indrekluuk/RobotexLineFollowerMain/pcb/MainBoard/Drill.png

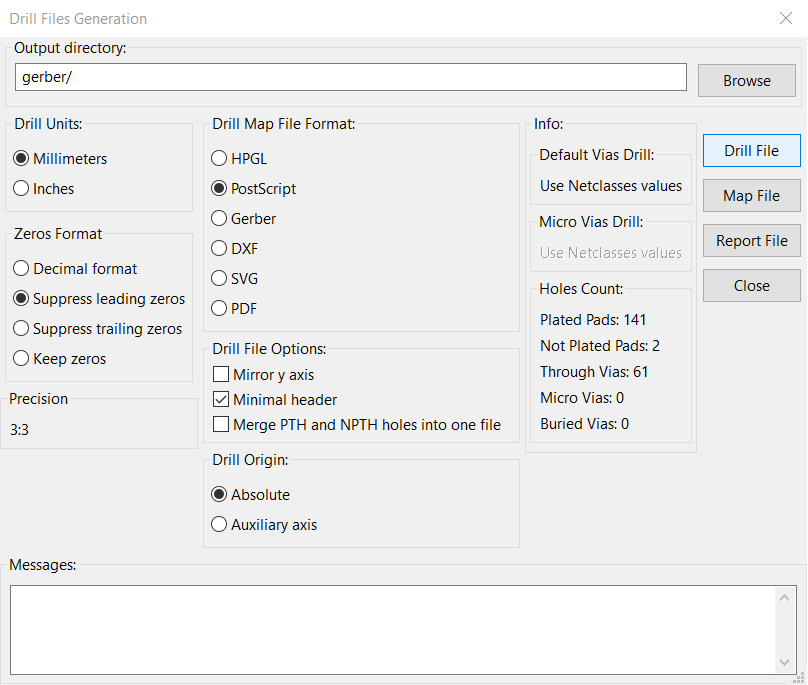
pcb/MainBoard/Drill.png
