indrekluuk/RobotexLineFollowerMain/pcb/MainBoard/MainBoard.kicad_pcb

## KiCad design pcb/MainBoard/MainBoard.kicad_pcb (2016-11-05)

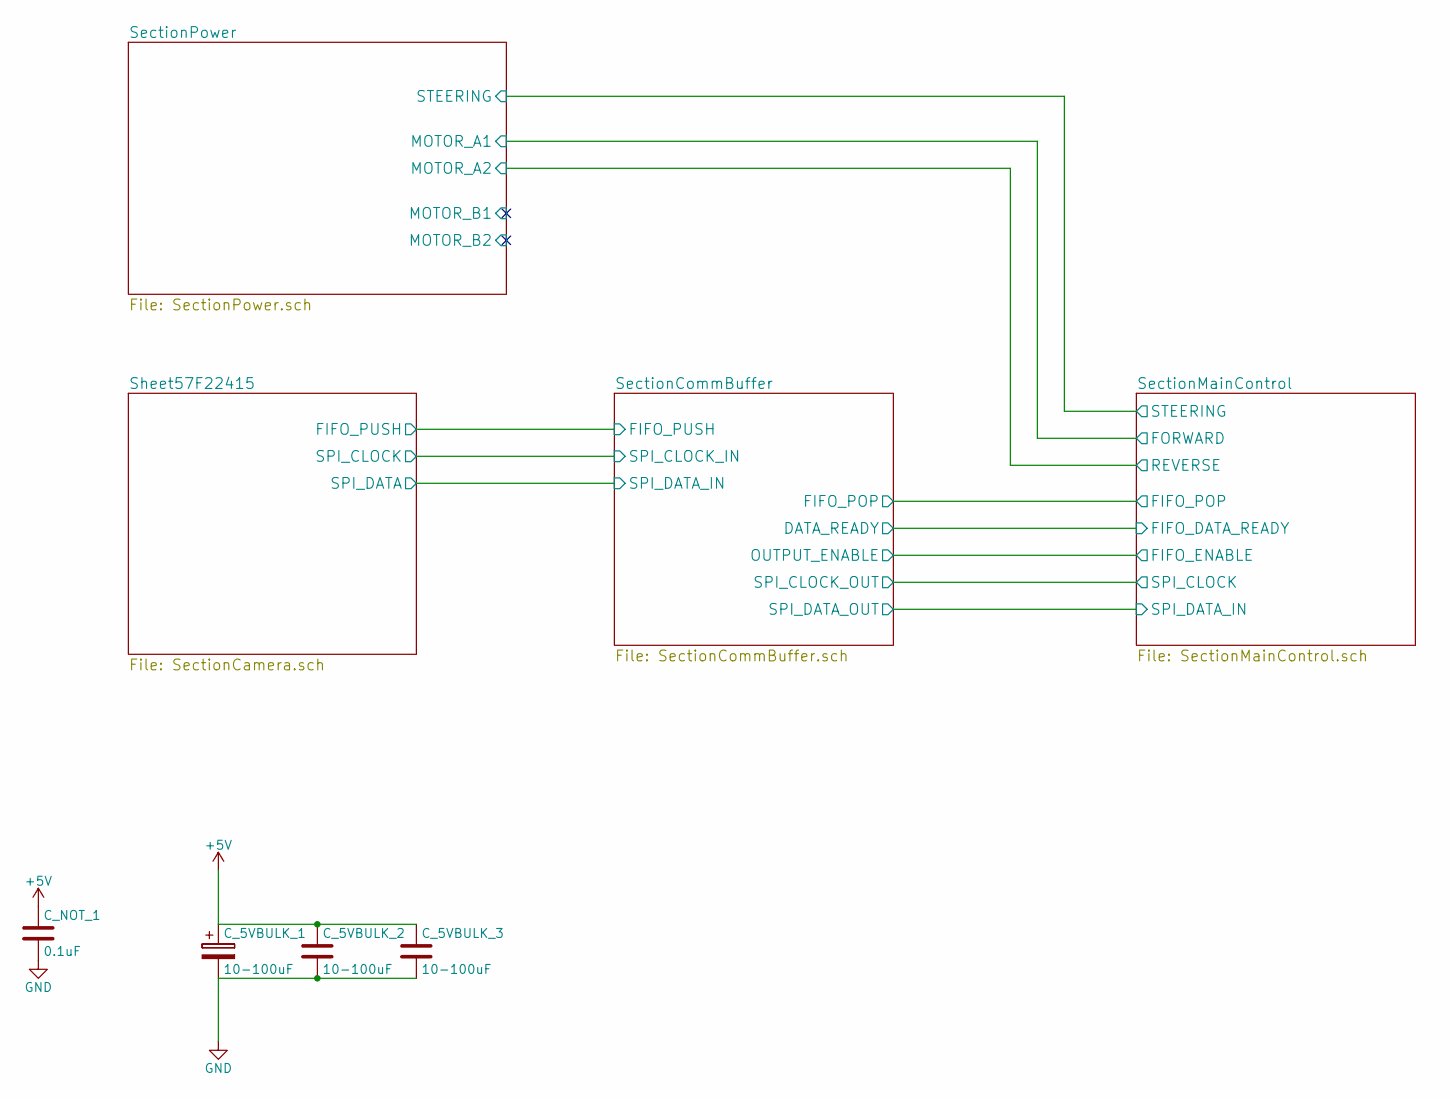
[picture p3: schematic MainBoard.sch]

Parts:
C_5VBULK_1: 10-100uF; C_Radial_D6.3_L11.2_P2.5
C_5VBULK_2, C_5VBULK_3: 10-100uF; C_1206_HandSoldering
C_NOT_1: 0.1uF; C_1206_HandSoldering

Connections:
+5V: C_5VBULK_1.1, C_5VBULK_2.1, C_5VBULK_3.1, C_NOT_1.1; also elsewhere on the board
GND: C_5VBULK_1.2, C_5VBULK_2.2, C_5VBULK_3.2, C_NOT_1.2; also elsewhere on the board

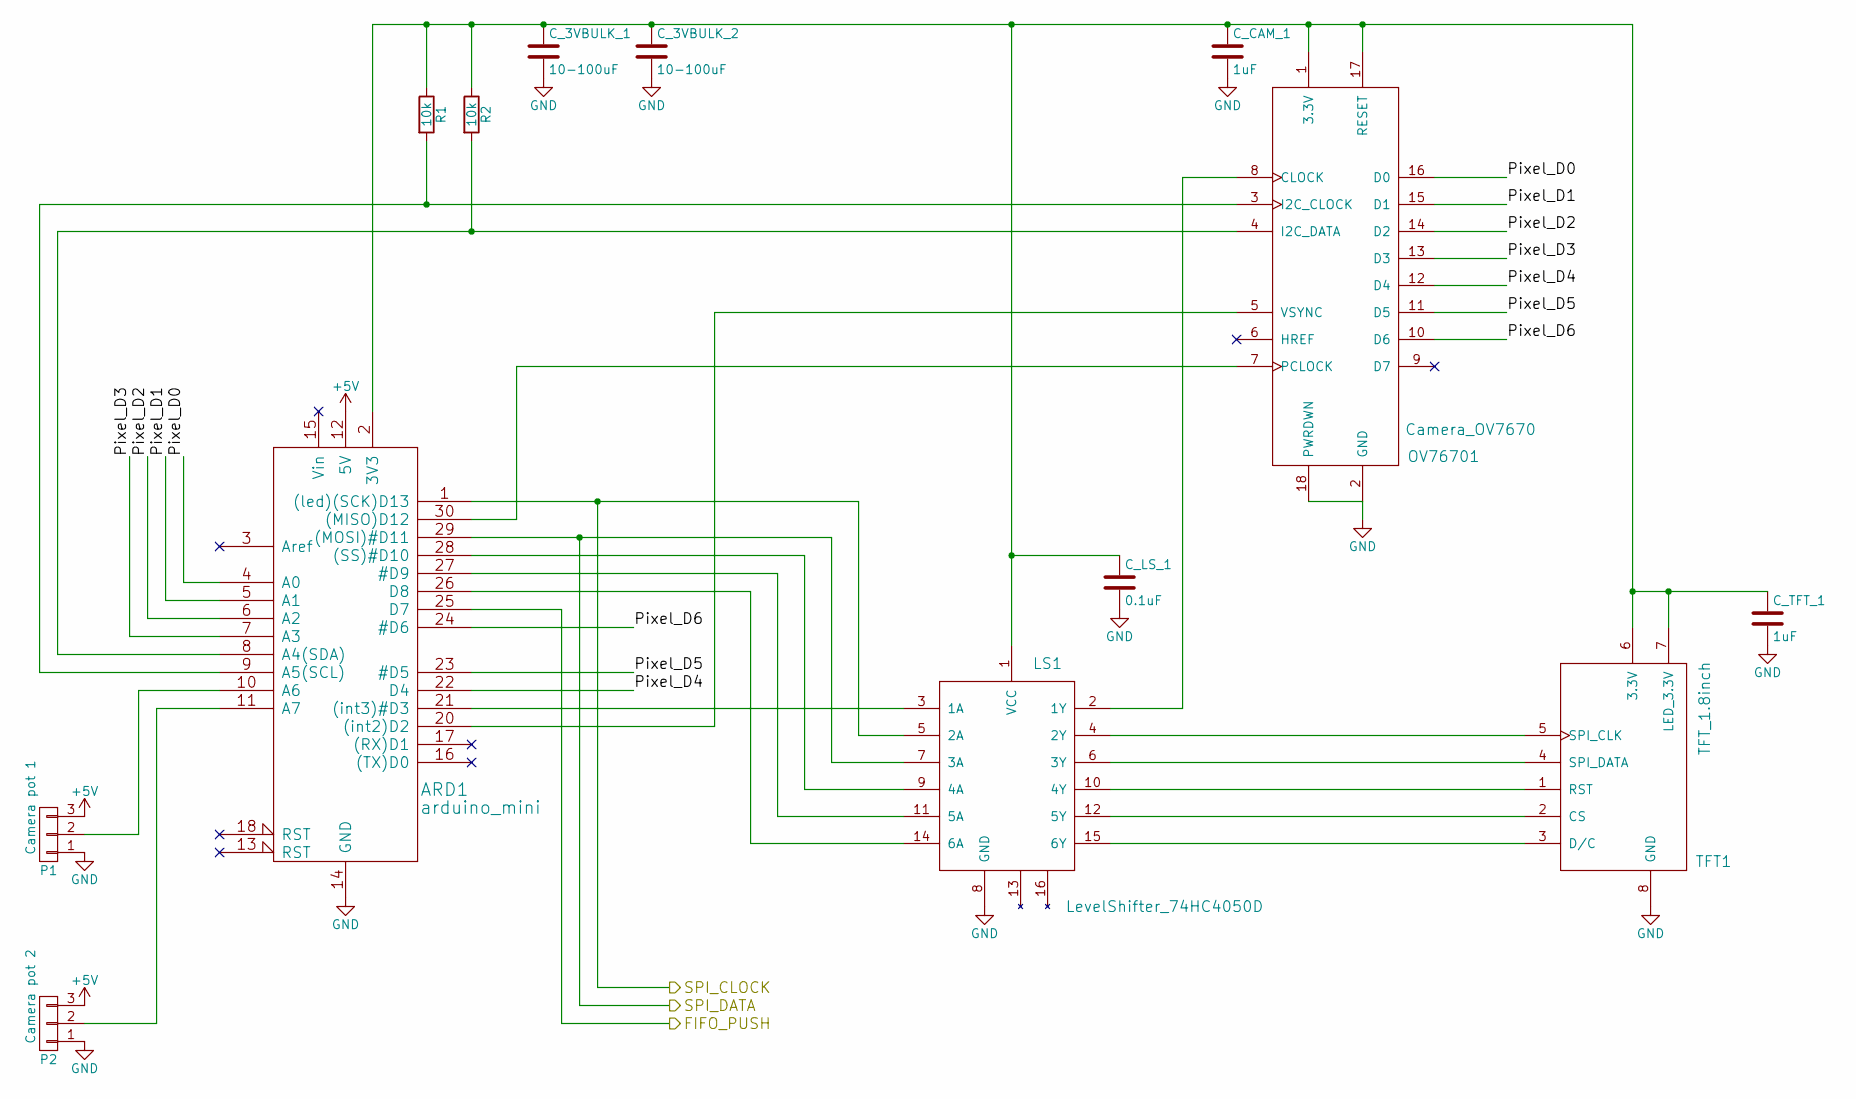
[picture p4: schematic SectionCamera.sch]

Parts:
ARD1: arduino_mini
C_3VBULK_1, C_3VBULK_2: 10-100uF; C_1206_HandSoldering
C_CAM_1: 1uF; C_1206_HandSoldering
C_LS_1: 0.1uF; C_1206_HandSoldering
C_TFT_1: 1uF; C_1206_HandSoldering
LS1: LevelShifter_74HC4050D; SOIC-16_3.9x9.9mm_Pitch1.27mm
OV76701: Camera_OV7670; Pin_Header_Straight_2x09
P1: Camera pot 1; Pin_Header_Straight_1x03
P2: Camera pot 2; Pin_Header_Straight_1x03
R1, R2: 10k; R_1206_HandSoldering
TFT1: TFT_1.8inch; Pin_Header_Straight_2x04

Connections:
+5V: ARD1.12 (5V), P1.3, P2.3; also elsewhere on the board
/SectionCommBuffer/FIFO_PUSH: ARD1.25 (D7); also elsewhere on the board
/Sheet57F22415/Pixel_D0: ARD1.4 (A0), OV76701.16 (D0)
/Sheet57F22415/Pixel_D1: ARD1.5 (A1), OV76701.15 (D1)
/Sheet57F22415/Pixel_D2: ARD1.6 (A2), OV76701.14 (D2)
/Sheet57F22415/Pixel_D3: ARD1.7 (A3), OV76701.13 (D3)
/Sheet57F22415/Pixel_D4: ARD1.22 (D4), OV76701.12 (D4)
/Sheet57F22415/Pixel_D5: ARD1.23 (#D5), OV76701.11 (D5)
/Sheet57F22415/Pixel_D6: ARD1.24 (#D6), OV76701.10 (D6)
/Sheet57F22415/SPI_CLOCK: ARD1.1 ((led)(SCK)D13), LS1.5 (2A); also elsewhere on the board
/Sheet57F22415/SPI_DATA: ARD1.29 ((MOSI)#D11), LS1.7 (3A); also elsewhere on the board
GND: ARD1.14 (GND), ARD1.19 (GND), C_3VBULK_1.2, C_3VBULK_2.2, C_CAM_1.2, C_LS_1.2, C_TFT_1.2, LS1.8 (GND), OV76701.2 (GND), OV76701.18 (PWRDWN), P1.1, P2.1, TFT1.8 (GND); also elsewhere on the board
unnamed: ARD1.2 (3V3), C_3VBULK_1.1, C_3VBULK_2.1, C_CAM_1.1, C_LS_1.1, C_TFT_1.1, LS1.1 (VCC), OV76701.1 (3.3V), OV76701.17 (RESET), R1.1, R2.1, TFT1.6 (3.3V), TFT1.7 (LED_3.3V)
unnamed: ARD1.8 (A4(SDA)), OV76701.4 (I2C_DATA), R2.2
unnamed: ARD1.9 (A5(SCL)), OV76701.3 (I2C_CLOCK), R1.2
unnamed: ARD1.10 (A6), P1.2
unnamed: ARD1.11 (A7), P2.2
unnamed: ARD1.20 ((int2)D2), OV76701.5 (VSYNC)
unnamed: ARD1.21 ((int3)#D3), LS1.3 (1A)
unnamed: ARD1.26 (D8), LS1.14 (6A)
unnamed: ARD1.27 (#D9), LS1.11 (5A)
unnamed: ARD1.28 ((SS)#D10), LS1.9 (4A)
unnamed: ARD1.30 ((MISO)D12), OV76701.7 (PCLOCK)
unnamed: LS1.2 (1Y), OV76701.8 (CLOCK)
unnamed: LS1.4 (2Y), TFT1.5 (SPI_CLK)
unnamed: LS1.6 (3Y), TFT1.4 (SPI_DATA)
unnamed: LS1.10 (4Y), TFT1.1 (RST)
unnamed: LS1.12 (5Y), TFT1.2 (CS)
unnamed: LS1.15 (6Y), TFT1.3 (D/C)

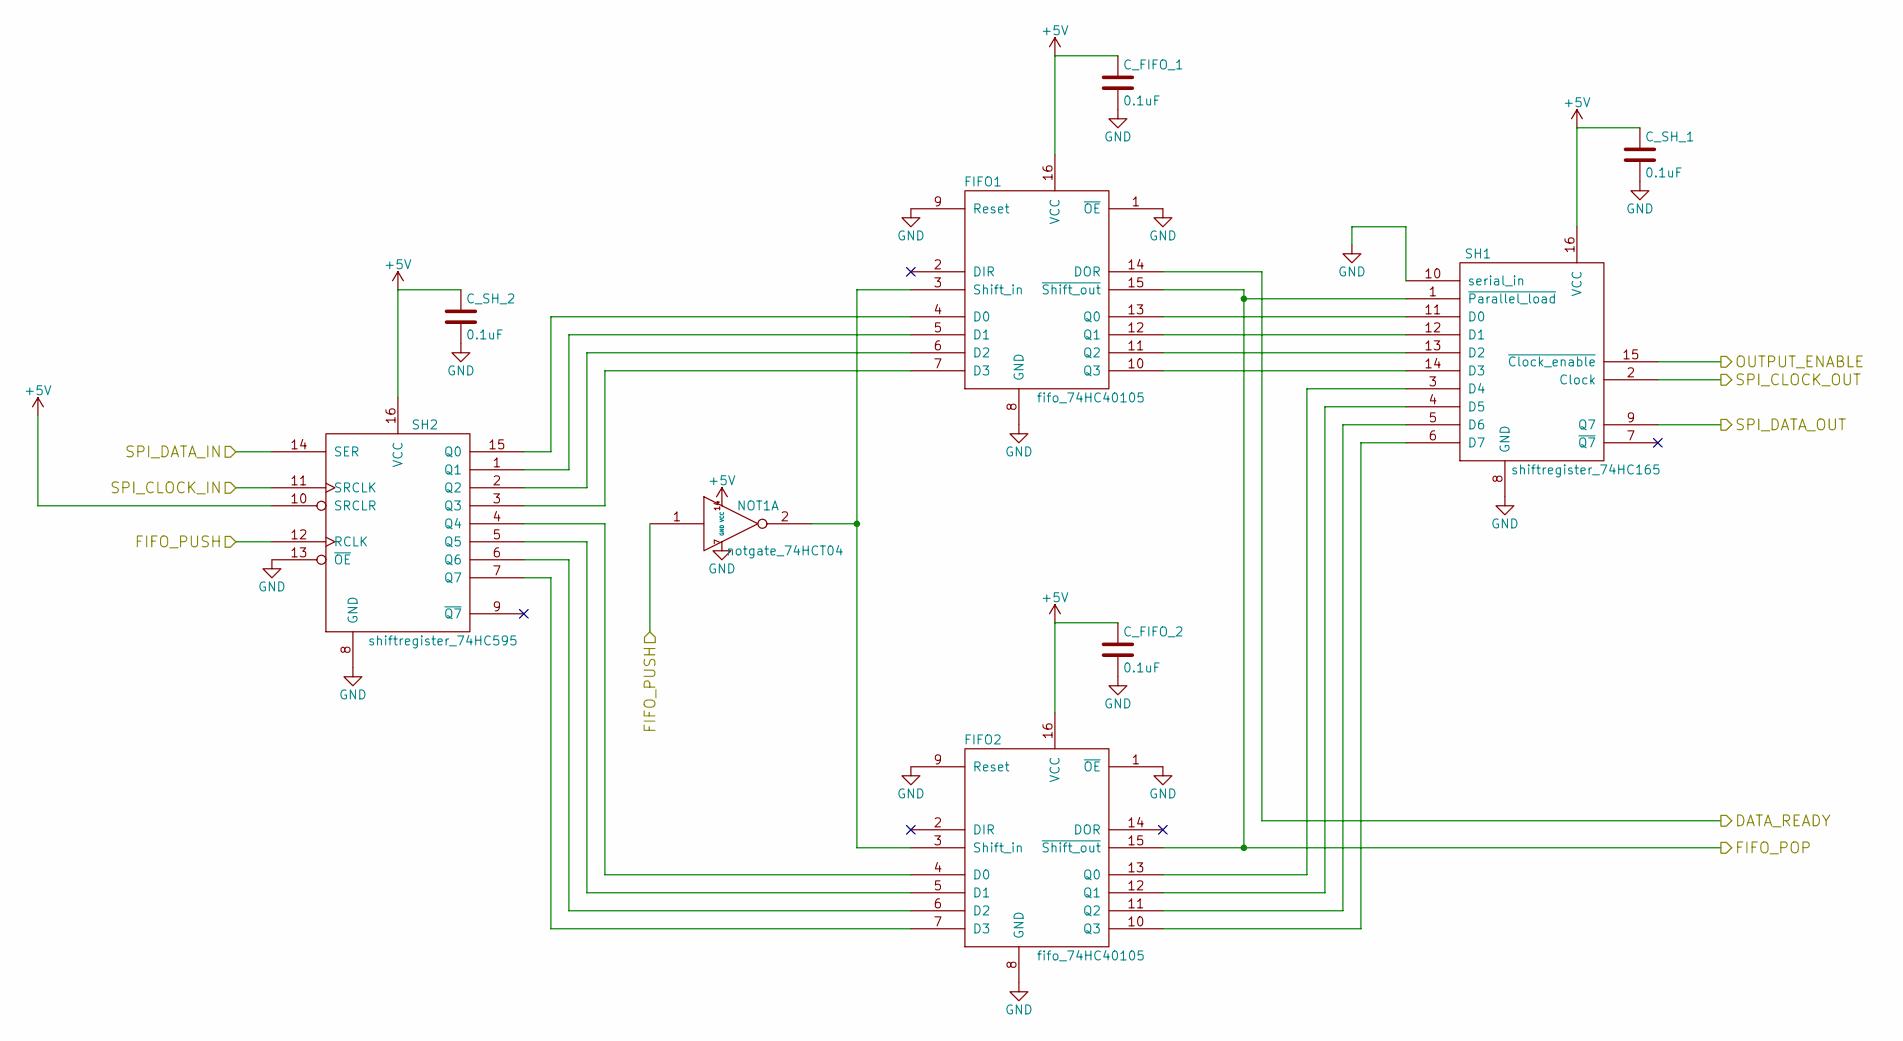
[picture p5: schematic SectionCommBuffer.sch]

Parts:
C_FIFO_1, C_FIFO_2: 0.1uF; C_1206_HandSoldering
C_SH_1, C_SH_2: 0.1uF; C_1206_HandSoldering
FIFO1, FIFO2: fifo_74HC40105; SOIC-16_3.9x9.9mm_Pitch1.27mm
NOT1: notgate_74HCT04; SOIC-14_3.9x8.7mm_Pitch1.27mm
SH1: shiftregister_74HC165; SOIC-16_3.9x9.9mm_Pitch1.27mm
SH2: shiftregister_74HC595; SOIC-16_3.9x9.9mm_Pitch1.27mm

Connections:
+5V: C_FIFO_1.1, C_FIFO_2.1, C_SH_1.1, C_SH_2.1, FIFO1.16 (VCC), FIFO2.16 (VCC), NOT1.14 (VCC), SH1.16 (VCC), SH2.10 (SRCLR), SH2.16 (VCC); also elsewhere on the board
/SectionCommBuffer/DATA_READY: FIFO1.14 (DOR); also elsewhere on the board
/SectionCommBuffer/FIFO_POP: FIFO1.15 (~Shift_out), FIFO2.15 (~Shift_out), SH1.1 (~Parallel_load); also elsewhere on the board
/SectionCommBuffer/FIFO_PUSH: NOT1.1, SH2.12 (RCLK); also elsewhere on the board
/SectionMainControl/FIFO_ENABLE: SH1.15 (~Clock_enable); also elsewhere on the board
/SectionMainControl/SPI_CLOCK: SH1.2 (Clock); also elsewhere on the board
/SectionMainControl/SPI_DATA_IN: SH1.9 (Q7); also elsewhere on the board
/Sheet57F22415/SPI_CLOCK: SH2.11 (SRCLK); also elsewhere on the board
/Sheet57F22415/SPI_DATA: SH2.14 (SER); also elsewhere on the board
GND: C_FIFO_1.2, C_FIFO_2.2, C_SH_1.2, C_SH_2.2, FIFO1.1 (~OE), FIFO1.8 (GND), FIFO1.9 (Reset), FIFO2.1 (~OE), FIFO2.8 (GND), FIFO2.9 (Reset), NOT1.7 (GND), SH1.8 (GND), SH1.10 (serial_in), SH2.8 (GND), SH2.13 (~OE); also elsewhere on the board
unnamed: FIFO1.3 (Shift_in), FIFO2.3 (Shift_in), NOT1.2
unnamed: FIFO1.4 (D0), SH2.15 (Q0)
unnamed: FIFO1.5 (D1), SH2.1 (Q1)
unnamed: FIFO1.6 (D2), SH2.2 (Q2)
unnamed: FIFO1.7 (D3), SH2.3 (Q3)
unnamed: FIFO1.10 (Q3), SH1.14 (D3)
unnamed: FIFO1.11 (Q2), SH1.13 (D2)
unnamed: FIFO1.12 (Q1), SH1.12 (D1)
unnamed: FIFO1.13 (Q0), SH1.11 (D0)
unnamed: FIFO2.4 (D0), SH2.4 (Q4)
unnamed: FIFO2.5 (D1), SH2.5 (Q5)
unnamed: FIFO2.6 (D2), SH2.6 (Q6)
unnamed: FIFO2.7 (D3), SH2.7 (Q7)
unnamed: FIFO2.10 (Q3), SH1.6 (D7)
unnamed: FIFO2.11 (Q2), SH1.5 (D6)
unnamed: FIFO2.12 (Q1), SH1.4 (D5)
unnamed: FIFO2.13 (Q0), SH1.3 (D4)

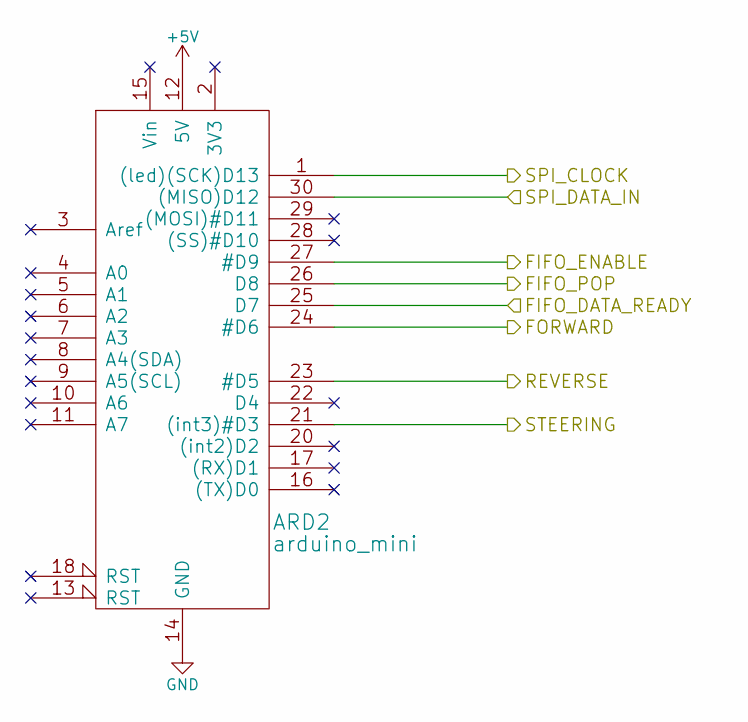
[picture p6: schematic SectionMainControl.sch]

Parts:
ARD2: arduino_mini

Connections:
+5V: ARD2.12 (5V); also elsewhere on the board
/SectionCommBuffer/DATA_READY: ARD2.25 (D7); also elsewhere on the board
/SectionCommBuffer/FIFO_POP: ARD2.26 (D8); also elsewhere on the board
/SectionMainControl/FIFO_ENABLE: ARD2.27 (#D9); also elsewhere on the board
/SectionMainControl/FORWARD: ARD2.24 (#D6); also elsewhere on the board
/SectionMainControl/SPI_CLOCK: ARD2.1 ((led)(SCK)D13); also elsewhere on the board
/SectionMainControl/SPI_DATA_IN: ARD2.30 ((MISO)D12); also elsewhere on the board
/SectionMainControl/STEERING: ARD2.21 ((int3)#D3); also elsewhere on the board
/SectionPower/MOTOR_A2: ARD2.23 (#D5); also elsewhere on the board
GND: ARD2.14 (GND), ARD2.19 (GND); also elsewhere on the board

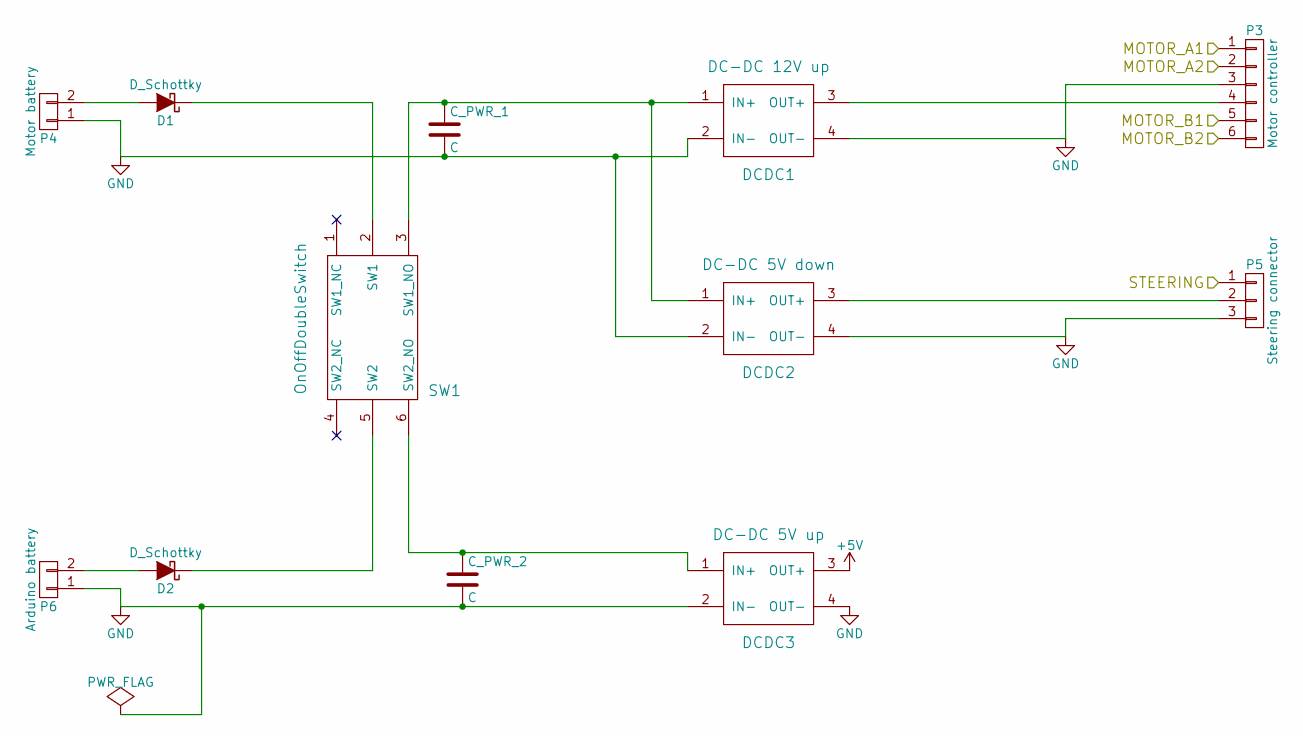
[picture p7: schematic SectionPower.sch]

Parts:
C_PWR_1, C_PWR_2: C; C_Radial_D6.3_L11.2_P2.5
D1, D2: D_Schottky; Diode_DO-35_SOD27_Horizontal_RM10
DCDC1: DC-DC 12V up; DcDcAdjustableUp
DCDC2: DC-DC 5V down; DcDcAdjustableDown
DCDC3: DC-DC 5V up; DcDc5VUp
P3: Motor controller; MotorController
P4: Motor battery; Pin_Header_Straight_1x02
P5: Steering connector; Pin_Header_Straight_1x03
P6: Arduino battery; Pin_Header_Straight_1x02
SW1: OnOffDoubleSwitch

Connections:
+5V: DCDC3.3 (OUT+); also elsewhere on the board
/SectionMainControl/FORWARD: P3.1; also elsewhere on the board
/SectionMainControl/STEERING: P5.1; also elsewhere on the board
/SectionPower/MOTOR_A2: P3.2; also elsewhere on the board
/SectionPower/MOTOR_B1: P3.5
/SectionPower/MOTOR_B2: P3.6
GND: C_PWR_1.2, C_PWR_2.2, DCDC1.2 (IN-), DCDC1.4 (OUT-), DCDC2.2 (IN-), DCDC2.4 (OUT-), DCDC3.2 (IN-), DCDC3.4 (OUT-), P3.3, P4.1, P5.3, P6.1; also elsewhere on the board
unnamed: C_PWR_1.1, DCDC1.1 (IN+), DCDC2.1 (IN+), SW1.3 (SW1_NO)
unnamed: C_PWR_2.1, DCDC3.1 (IN+), SW1.6 (SW2_NO)
unnamed: D1.1 (K), SW1.2 (SW1)
unnamed: D1.2 (A), P4.2
unnamed: D2.1 (K), SW1.5 (SW2)
unnamed: D2.2 (A), P6.2
unnamed: DCDC1.3 (OUT+), P3.4
unnamed: DCDC2.3 (OUT+), P5.2

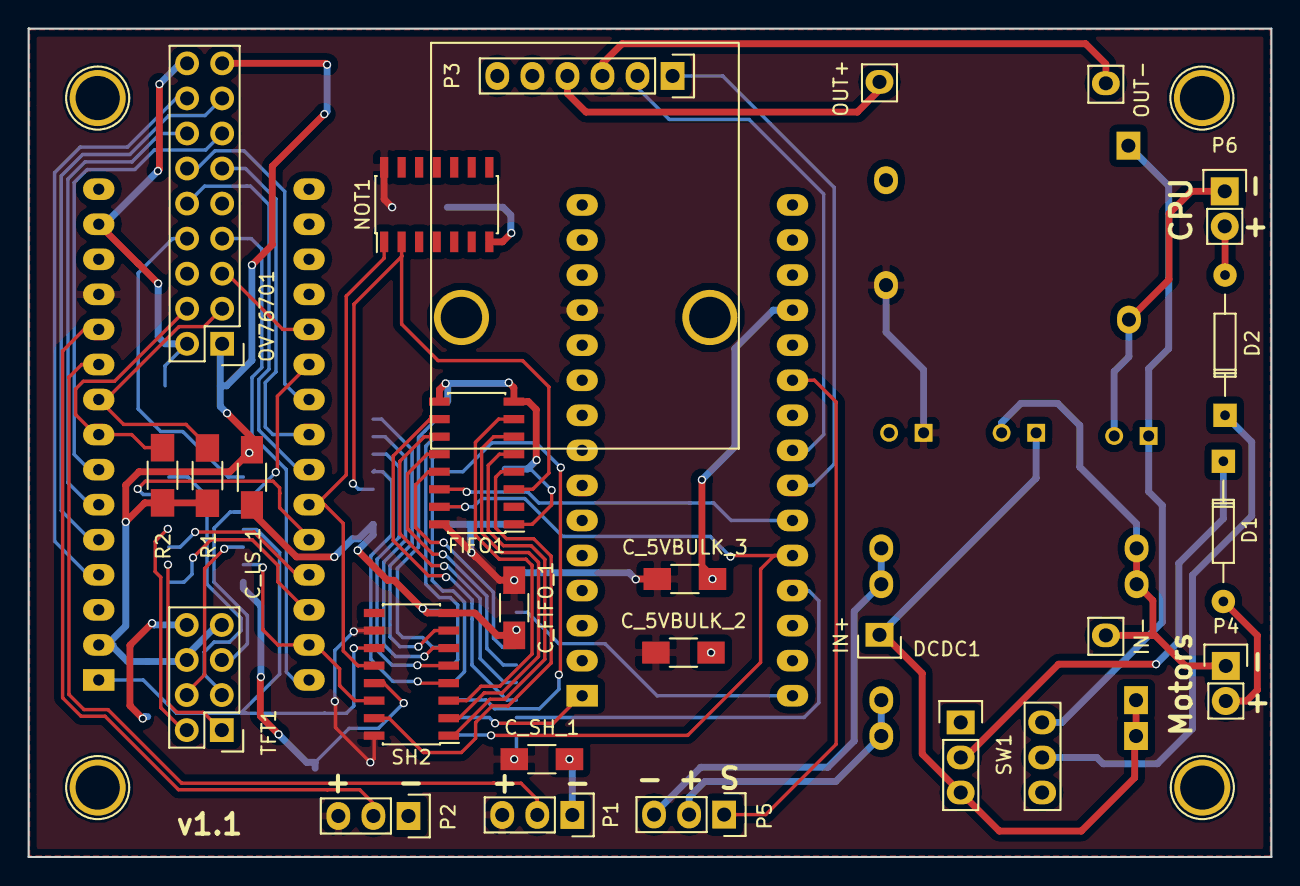
[picture p8: board MainBoard.kicad_pcb from above]

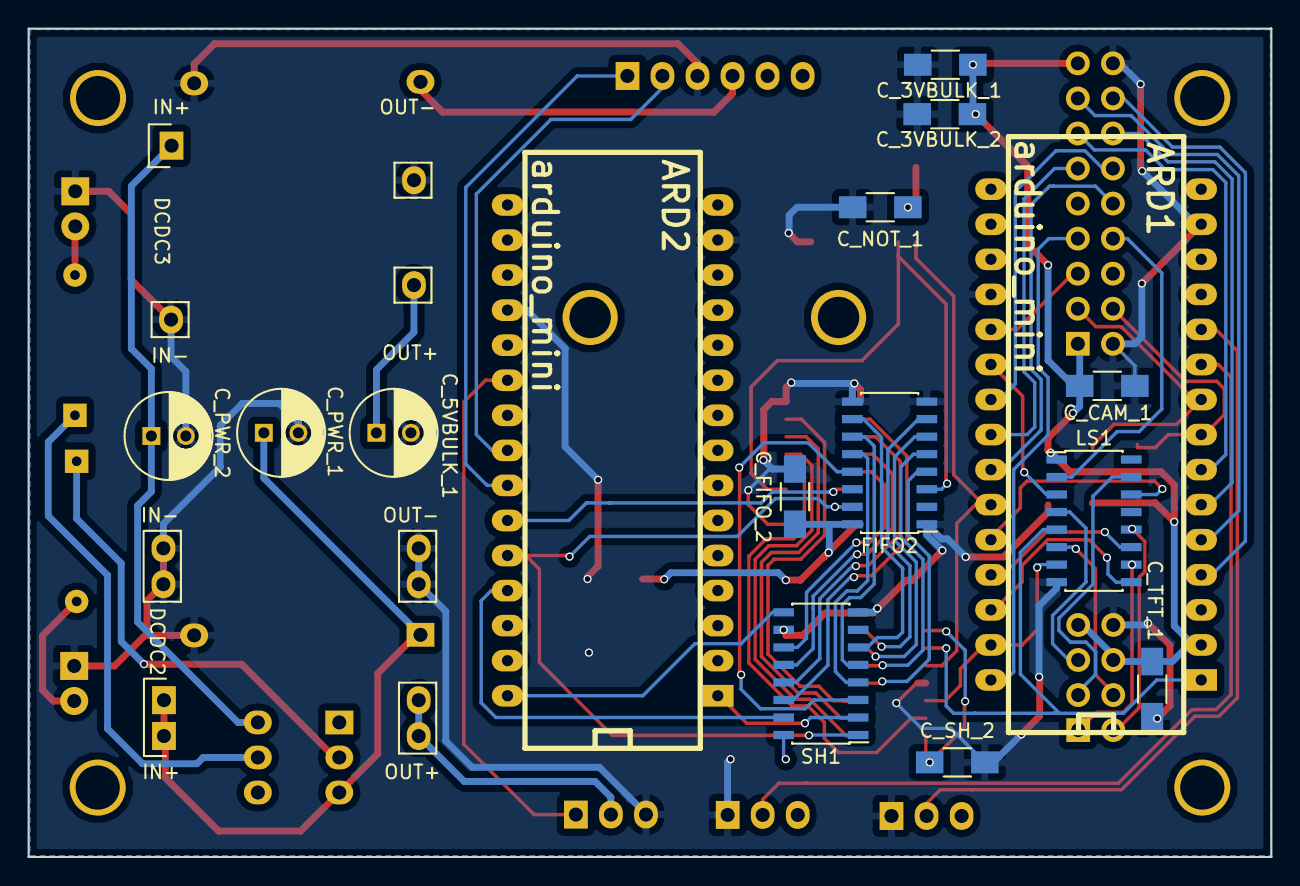
[picture p9: board MainBoard.kicad_pcb from below]

Board: 2 copper layers, 90.0 x 60.0 mm, 39 parts (17 on the bottom side), 62 nets.
