indrekluuk/RobotexLineFollowerMain/arduino/src/main.cpp

//
// Created by indrek on 20.09.2016.
//


#include "engine/Engine.h"
#include "steering/FrontWheels.h"
#include "steering/Steering.h"
#include "cameramessages/Message.h"
#include "cameramessages/messagebuffer/LineSegmentMessageBuffer.h"


// 0 - not disabled
// 1 - disable engine only
// 2 - disable all
#define DISABLE_CONTROLS 0



int PIN_FORWARD = 6;
int PIN_REVERSE = 5;
int PIN_FRONT_WHEELS = 3;



Engine engine(PIN_FORWARD, PIN_REVERSE);
FrontWheels frontWheels;
Steering steering(frontWheels);



void lineSegmentReceived(LineSegment & line);
void angleTest();


void run() {
  Serial.begin(250000);

#if DISABLE_CONTROLS != 2
  frontWheels.init(PIN_FRONT_WHEELS);
  //angleTest();

  steering.center();

  Serial.println("Waiting...");
  delay(5000);
  Serial.println("Start");

  Message message(lineSegmentReceived);
  while(1) {
    message.waitForMessage();
  }
#endif
}


void angleTest() {
  /*
  frontWheels.setPositionRange(100);

  while(true) {
    frontWheels.set(0);
    delay(3000);
    frontWheels.set(-100);
    delay(3000);
    frontWheels.set(-90);
    delay(3000);
    frontWheels.set(-80);
    delay(3000);
    frontWheels.set(-70);
    delay(3000);
  }

  */
}



int defaultPower = 90;
int8_t x1 = -1;
int16_t x1_count;
int16_t boostCount = 0;


void lineSegmentReceived(LineSegment & line) {
  bool isReverse = steering.steer(line);


  /*
  Serial.print("x1=");
  Serial.print((int)line.x1);

  Serial.print("; y1=");
  Serial.print((int)line.y1);

  Serial.print("; x2=");
  Serial.print((int)line.x2);

  Serial.print("; y2=");
  Serial.print((int)line.y2);

  Serial.print("is end ");
  Serial.print(line.isEndOfLine);

  Serial.println("\n");
   */

#if DISABLE_CONTROLS == 0


  int power = defaultPower;
  if (x1 == line.x1) {
    x1_count ++;
  } else {
    x1_count = 0;
    x1 = line.x1;
  }

  if (x1_count > 30) { // 3 seconds
    power = 255;
    x1_count = 0;
    boostCount++;
    if (boostCount > 3) {
      defaultPower += 5;
      boostCount = 0;
    }
  }

  if (isReverse) {
    engine.reverse(power);
  } else {
    engine.drive(power);
  }
#endif
}
