indrekluuk/RobotexLineFollowerMain/(commit log)

2016-07-10 power board layout done
2016-07-11 power board ready
    [PowerBoard-B.Cu.gbr, PowerBoard-B.Mask.gbr, PowerBoard-B.SilkS.gbr, PowerBoard-Edge.Cuts.gbr, PowerBoard-F.Cu.gbr, PowerBoard-F.Mask.gbr, PowerBoard-F.SilkS.gbr, PowerBoard.drl]
2016-10-09 schema for unified board
    [MainBoard.kicad_pcb, MainBoard.sch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]
2016-10-09 PCB design finished
    [MainBoard.kicad_pcb, MainBoard.sch, SectionCamera.sch, SectionCommBuffer.sch, SectionMainControl.sch, SectionPower.sch]
2016-10-09 generated gerber files
    [MainBoard-B.Cu.gbl, MainBoard-B.Mask.gbs, MainBoard-B.SilkS.gbo, MainBoard-Edge.Cuts.gm1, MainBoard-F.Cu.gtl, MainBoard-F.Mask.gts, MainBoard-F.SilkS.gto, MainBoard-NPTH.drl]
2016-11-05 fixed power module ground connections
    [MainBoard.kicad_pcb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]
2016-11-05 re-assigned data ready from pin 10 to pin 7.
    [MainBoard.kicad_pcb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]
2016-11-13 print out detected line end
2016-11-13 no interrupts during data read
2016-11-27 steer frown wheels
2016-11-27 steering with range limit
2016-11-27 init front wheels separately for better debugging
2016-11-27 separate class for steering mapping
2016-11-27 working with simple track
2016-11-28 Map screen to world coordinates
    [ScreenToWorld_Y.ods]
2016-11-28 track world X
2016-11-29 end of line and egnine reverse
    [Message.cpp, main.cpp]
2016-11-30 wiggle wheels if stuck
    [Steering.cpp, Steering.h, main.cpp]
2016-12-01 line index to screen to world map
    [ScreenToWorld_Y.ods]
2016-12-02 give boost if doesn't move for 3 seconds
    [main.cpp]
